Ellenleong/2025-26-RCJ-Soccer-IR-PCMS/README.md

# 2025-26-RCJ-Soccer-IR-PCMS
Record some soccer robot-related content from this year.
