Ellenleong/2025-26-RCJ-Soccer-IR-PCMS/Hardware/PCB/PCB circuit schematic/ir_pcb.png

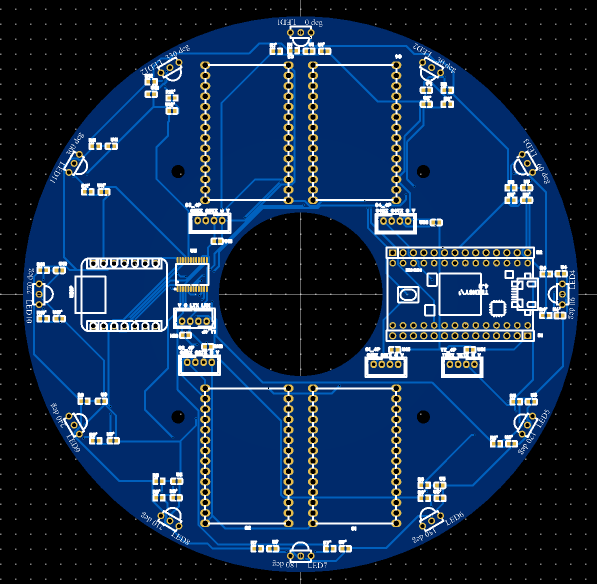
Hardware/PCB/PCB circuit schematic/ir_pcb.png
