Ellenleong/2025-26-RCJ-Soccer-IR-PCMS/Hardware/PCB/PCB circuit schematic/main_pcb.png

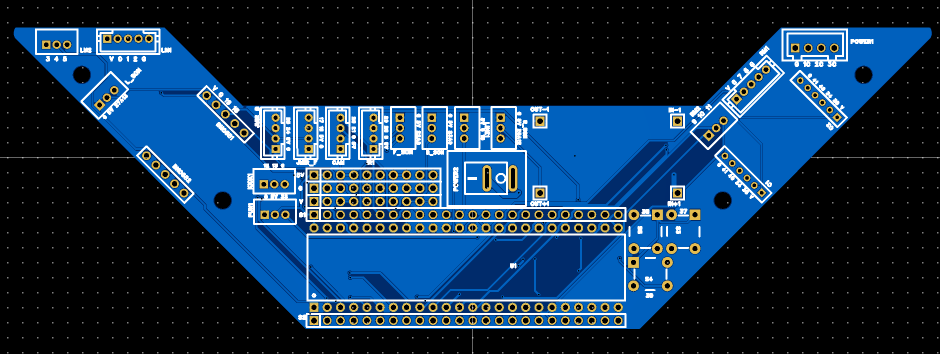
Hardware/PCB/PCB circuit schematic/main_pcb.png
