Ellenleong/2025-26-RCJ-Soccer-IR-PCMS/Hardware/Airframe design CAD file/dribbler/dribbler/Dribbler_assembled.step

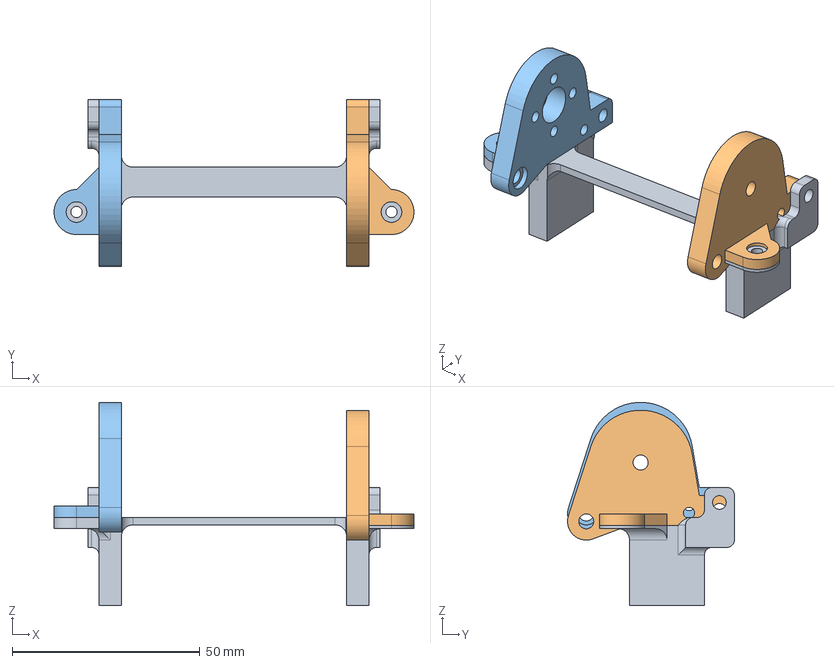
[picture p47: CAD file, 2026-06-27]
Hardware/Airframe design CAD file/dribbler/dribbler/Dribbler_assembled.step
96.0 x 44.5 x 54.2 mm
Dribbler_V3_P1
Dribbler_V3_P2
Dribbler_V3_P3
