Ellenleong/2025-26-RCJ-Soccer-IR-PCMS/Hardware/Airframe design CAD file/batteryholder/BatteryHolder.step

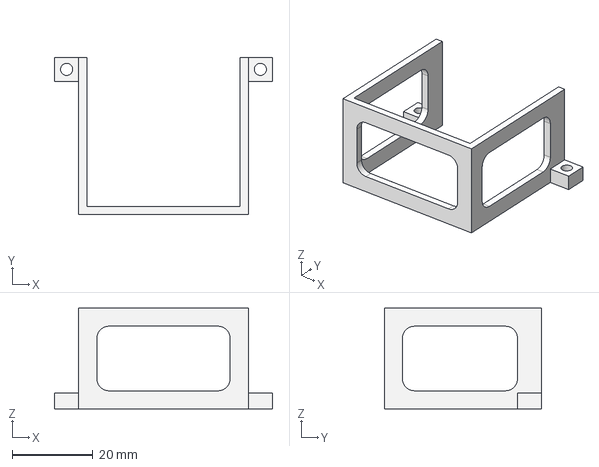
[picture p48: CAD file, 2026-06-27]
Hardware/Airframe design CAD file/batteryholder/BatteryHolder.step
54.0 x 39.0 x 25.0 mm
