Ellenleong/2025-26-RCJ-Soccer-IR-PCMS/Hardware/Airframe design CAD file/dribbler/dribbler/Dribbler_V3_Part1.step

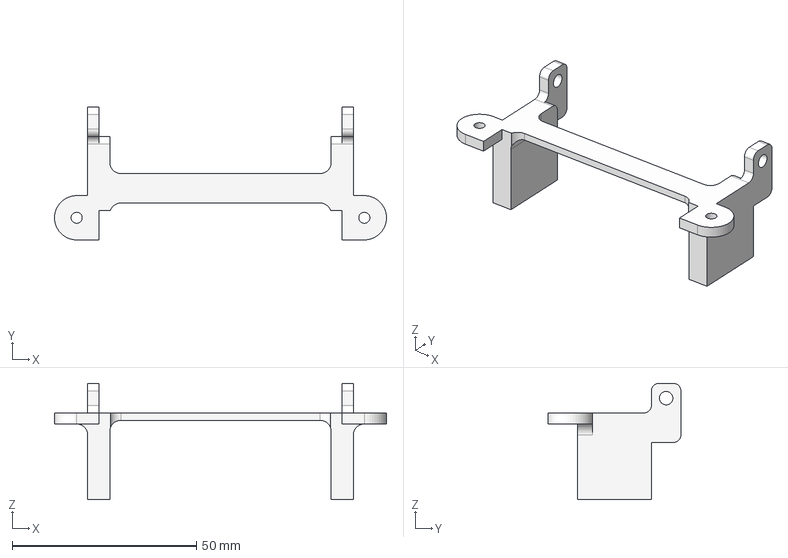
[picture p49: CAD file, 2026-06-27]
Hardware/Airframe design CAD file/dribbler/dribbler/Dribbler_V3_Part1.step
90.0 x 36.0 x 31.5 mm
