Ellenleong/2025-26-RCJ-Soccer-IR-PCMS/Hardware/Airframe design CAD file/dribbler/dribbler_mold/Dribbler_Mold2.step

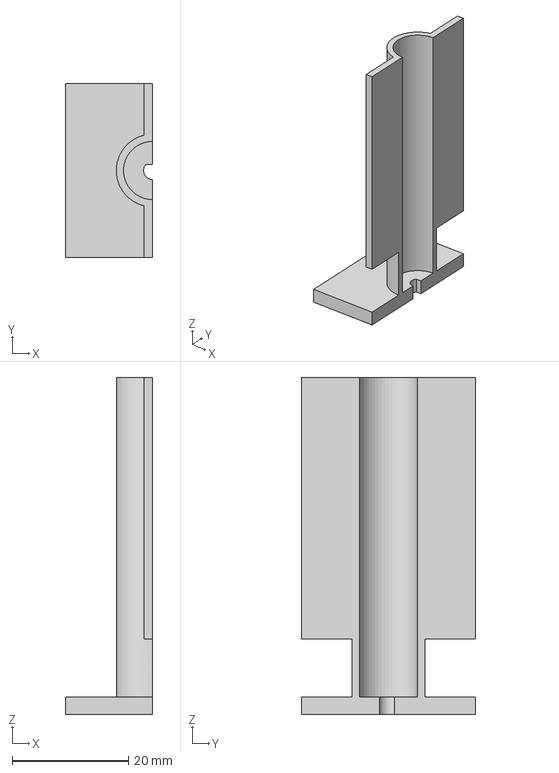
[picture p50: CAD file, 2026-06-27]
Hardware/Airframe design CAD file/dribbler/dribbler_mold/Dribbler_Mold2.step
15.0 x 30.0 x 58.0 mm
