Ellenleong/2025-26-RCJ-Soccer-IR-PCMS/Hardware/Airframe design CAD file/kicker/Kick_Standup_P1.step

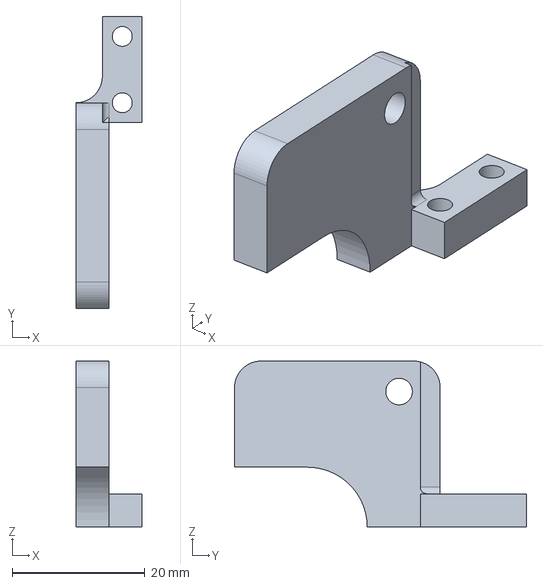
[picture p51: CAD file, 2026-06-27]
Hardware/Airframe design CAD file/kicker/Kick_Standup_P1.step
10.0 x 44.0 x 25.0 mm
