Ellenleong/2025-26-RCJ-Soccer-IR-PCMS/Hardware/Airframe design CAD file/motor/Re16_WheelConnector.step

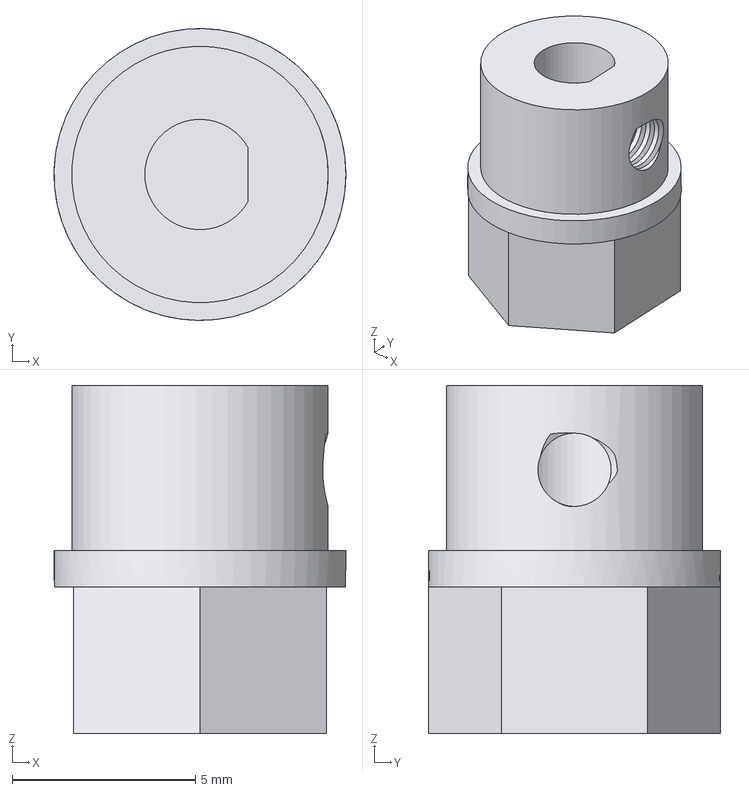
[picture p52: CAD file, 2026-06-27]
Hardware/Airframe design CAD file/motor/Re16_WheelConnector.step
7.97 x 7.97 x 9.50 mm
