Ellenleong/2025-26-RCJ-Soccer-IR-PCMS/Hardware/Airframe design CAD file/omniwheel/Wheel_PartB.step

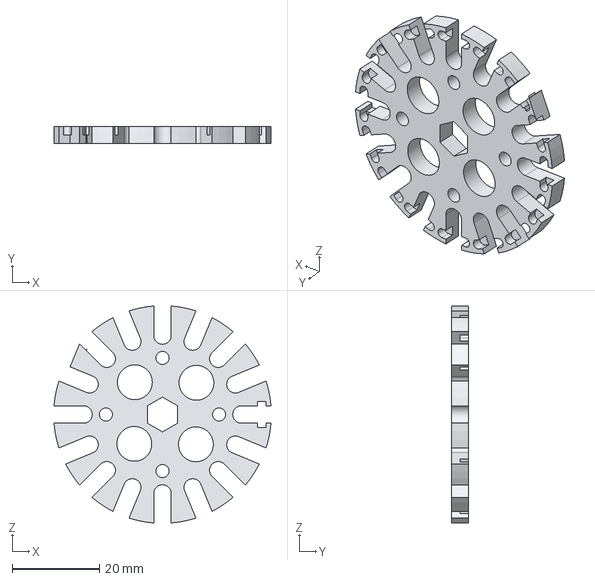
[picture p53: CAD file, 2026-06-27]
Hardware/Airframe design CAD file/omniwheel/Wheel_PartB.step
49.8 x 4.00 x 49.8 mm
