Ellenleong/2025-26-RCJ-Soccer-IR-PCMS/Hardware/Airframe design CAD file/shell/protector to chassis_front1.step

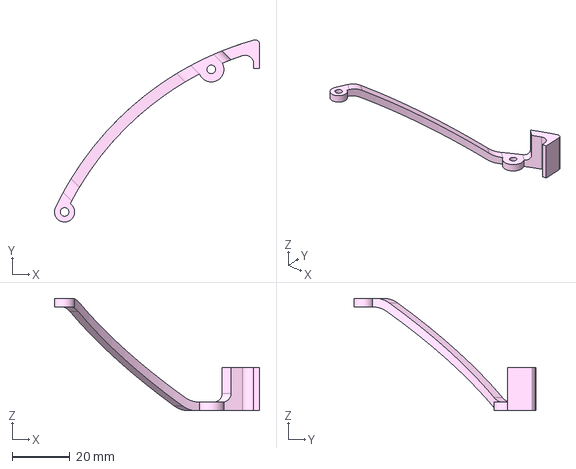
[picture p54: CAD file, 2026-06-27]
Hardware/Airframe design CAD file/shell/protector to chassis_front1.step
71.1 x 63.1 x 39.0 mm
