Ellenleong/2025-26-RCJ-Soccer-IR-PCMS/Hardware/Airframe design CAD file/support_for_sensor/camera&ultrasonic_support.step

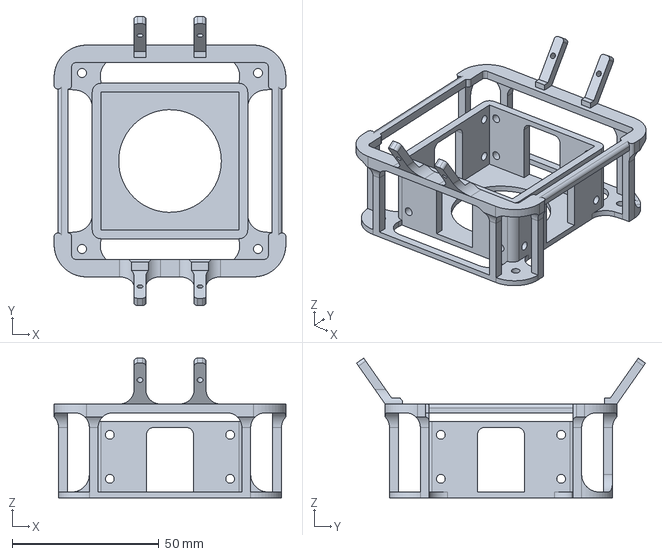
[picture p55: CAD file, 2026-06-27]
Hardware/Airframe design CAD file/support_for_sensor/camera&ultrasonic_support.step
79.0 x 98.5 x 47.6 mm
