Ellenleong/2025-26-RCJ-Soccer-IR-PCMS/Hardware/Airframe design CAD file/dribbler/dribbler/Dribbler_V3_Part2.step

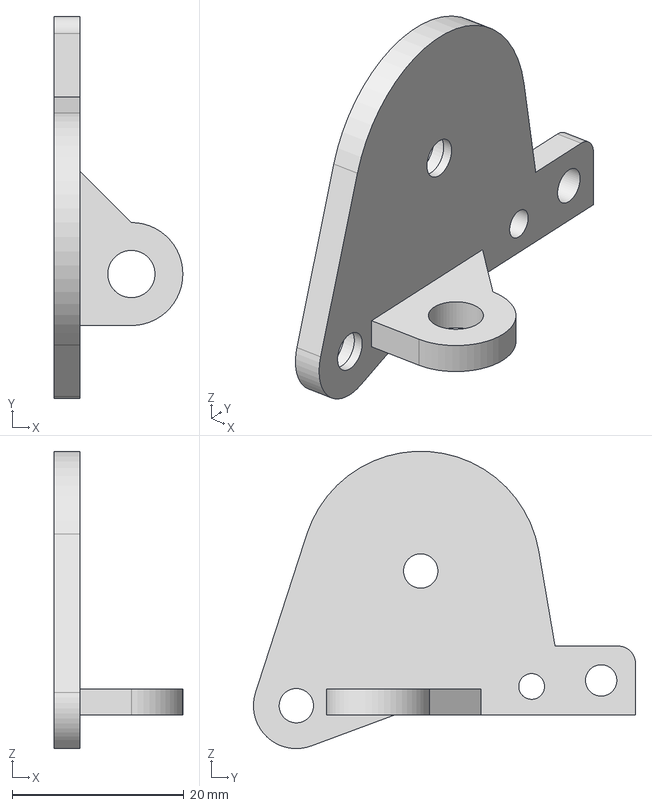
[picture p56: CAD file, 2026-06-27]
Hardware/Airframe design CAD file/dribbler/dribbler/Dribbler_V3_Part2.step
15.0 x 44.5 x 34.6 mm
