Ellenleong/2025-26-RCJ-Soccer-IR-PCMS/Hardware/Airframe design CAD file/dribbler/dribbler_mold/Dribbler_Mold1.step

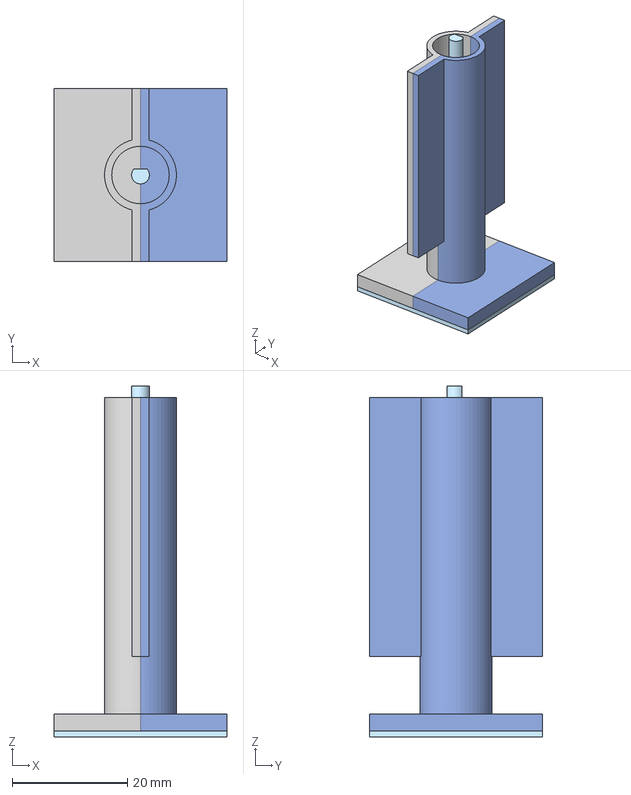
[picture p57: CAD file, 2026-06-27]
Hardware/Airframe design CAD file/dribbler/dribbler_mold/Dribbler_Mold1.step
30.0 x 30.0 x 61.0 mm
