Ellenleong/2025-26-RCJ-Soccer-IR-PCMS/Hardware/Airframe design CAD file/kicker/Kick_Face.step

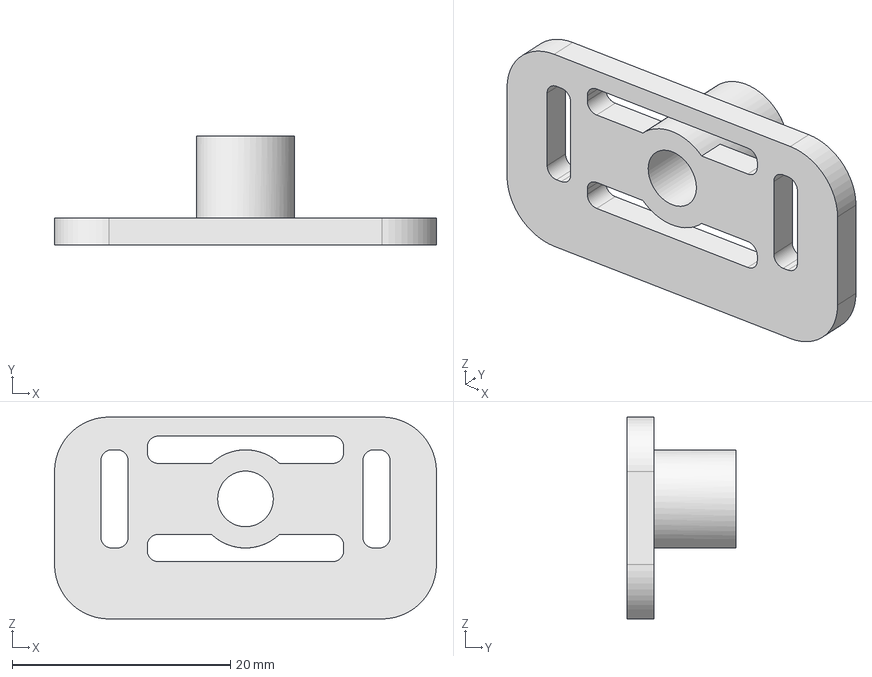
[picture p58: CAD file, 2026-06-27]
Hardware/Airframe design CAD file/kicker/Kick_Face.step
35.0 x 10.0 x 18.5 mm
