Ellenleong/2025-26-RCJ-Soccer-IR-PCMS/Hardware/Airframe design CAD file/motor/Re16_Stand.step

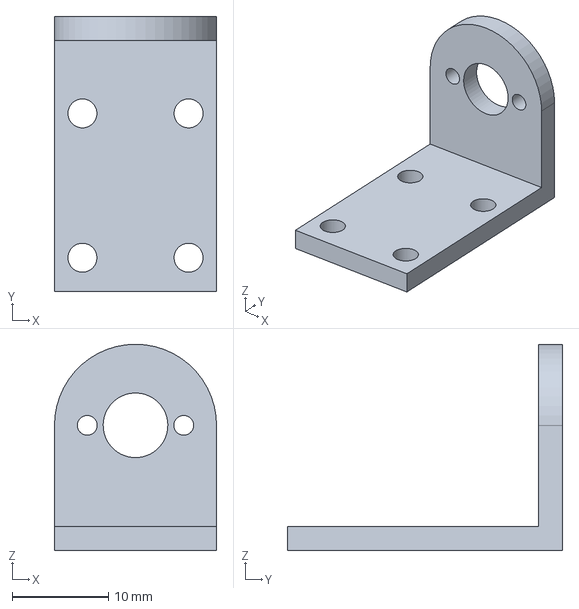
[picture p59: CAD file, 2026-06-27]
Hardware/Airframe design CAD file/motor/Re16_Stand.step
16.8 x 28.5 x 21.4 mm
