Ellenleong/2025-26-RCJ-Soccer-IR-PCMS/Hardware/Airframe design CAD file/omniwheel/Wheel_PartA.step

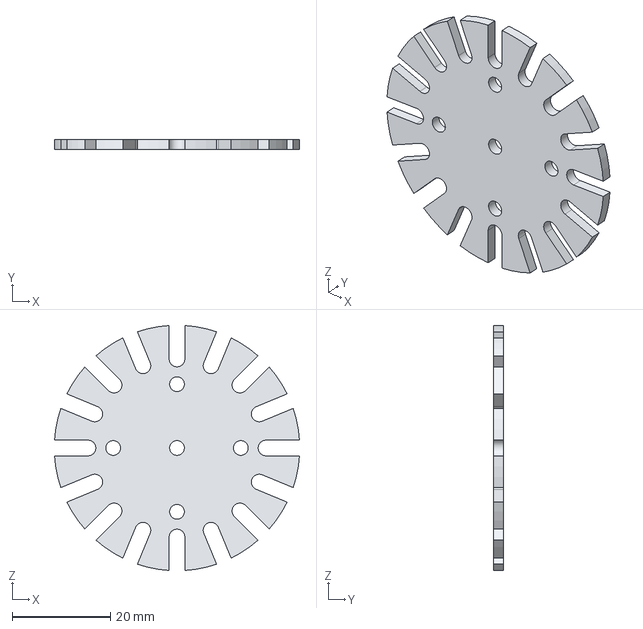
[picture p60: CAD file, 2026-06-27]
Hardware/Airframe design CAD file/omniwheel/Wheel_PartA.step
49.9 x 2.00 x 49.9 mm
