Ellenleong/2025-26-RCJ-Soccer-IR-PCMS/Hardware/Airframe design CAD file/shell/protector to chassis.step

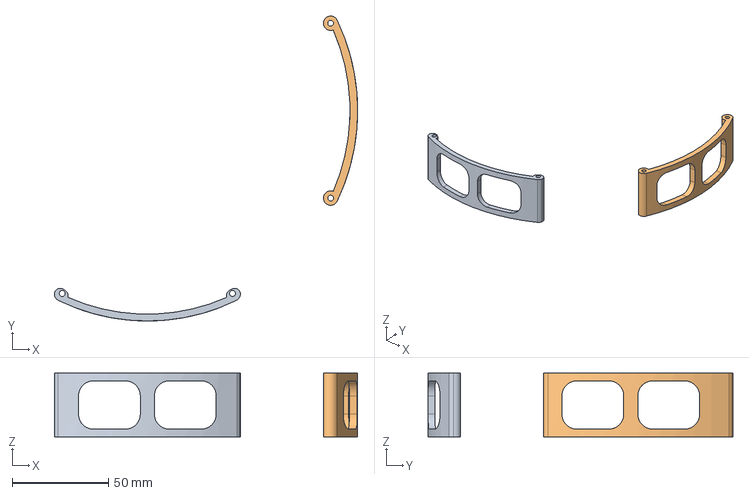
[picture p61: CAD file, 2026-06-27]
Hardware/Airframe design CAD file/shell/protector to chassis.step
157.2 x 158.1 x 33.0 mm
