Ellenleong/2025-26-RCJ-Soccer-IR-PCMS/Hardware/Airframe design CAD file/dribbler/dribbler/Dribbler_V3_Part3.step

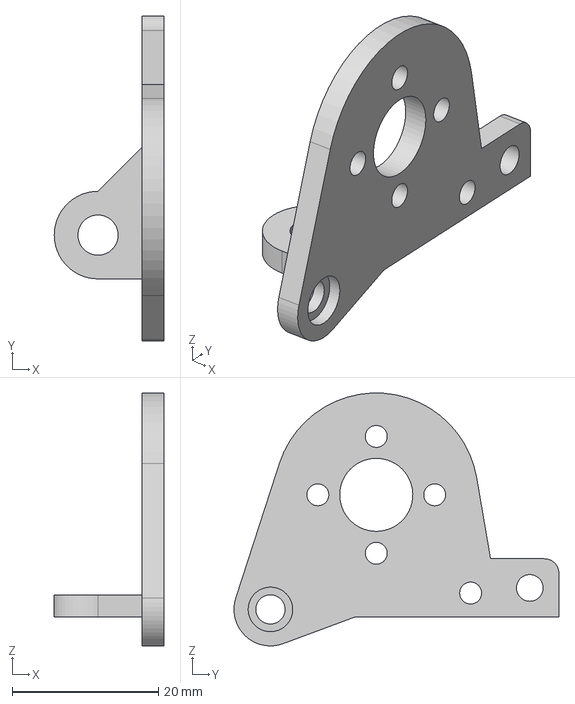
[picture p62: CAD file, 2026-06-27]
Hardware/Airframe design CAD file/dribbler/dribbler/Dribbler_V3_Part3.step
15.0 x 44.5 x 34.6 mm
