Ellenleong/2025-26-RCJ-Soccer-IR-PCMS/Hardware/Airframe design CAD file/shell/wheelprotector.step

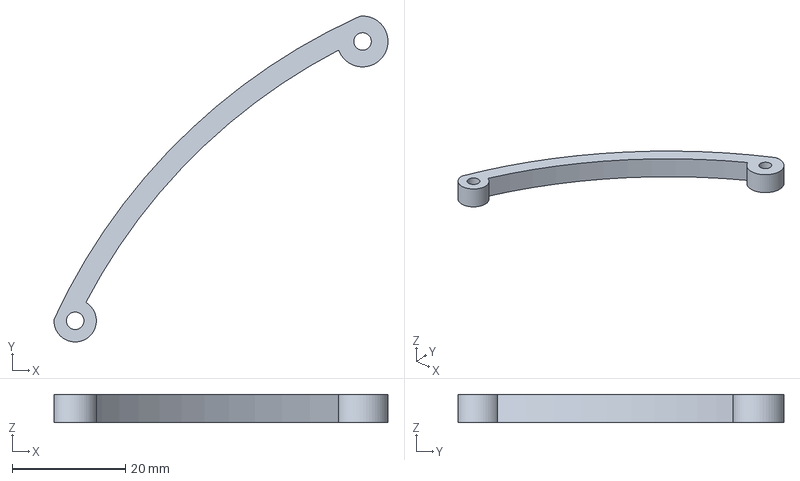
[picture p63: CAD file, 2026-06-27]
Hardware/Airframe design CAD file/shell/wheelprotector.step
59.1 x 57.7 x 5.00 mm
