Ellenleong/2025-26-RCJ-Soccer-IR-PCMS/(list of files, cad)

Other CAD files:
Hardware/Airframe design CAD file/kicker/Kick_Standup_P2.step
Hardware/Airframe design CAD file/shell/protector to chassis_front2.step
