Ellenleong/2025-26-RCJ-Soccer-IR-PCMS/Hardware/PCB/PCB 3D View/IRcircuit.pdf

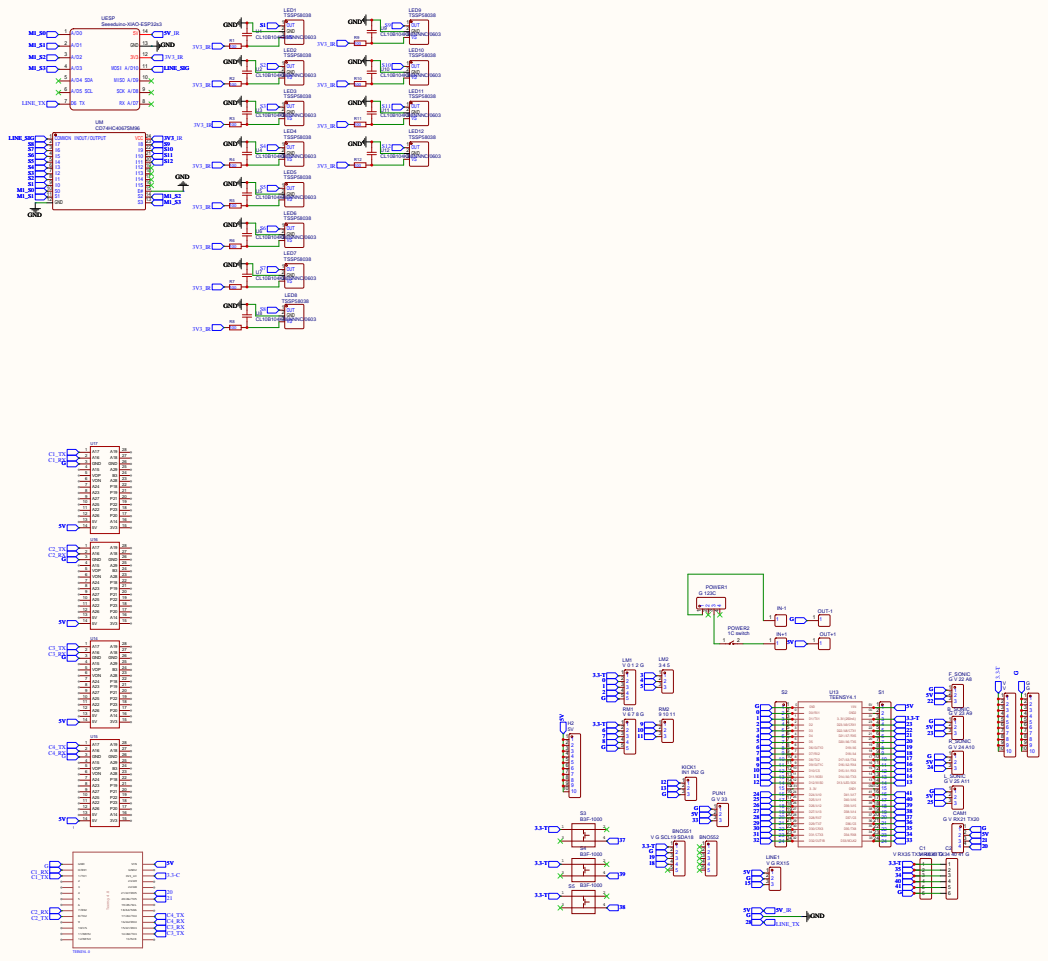
[picture p64: page 1]

原理图 | PCB_Main_IR_0504_V1 | 创建日期 | 2026-05-04

更新日期 | 2026-05-05

板子 | PCB_Main_IR_0504 | 图页 | P1
绘制 | | PCB_IR_03_29_V2
审阅

V1.0 | A4 | 嘉立创EDA
