Ellenleong/2025-26-RCJ-Soccer-IR-PCMS/Hardware/PCB/PCB 3D View/Kicker_circuit.pdf

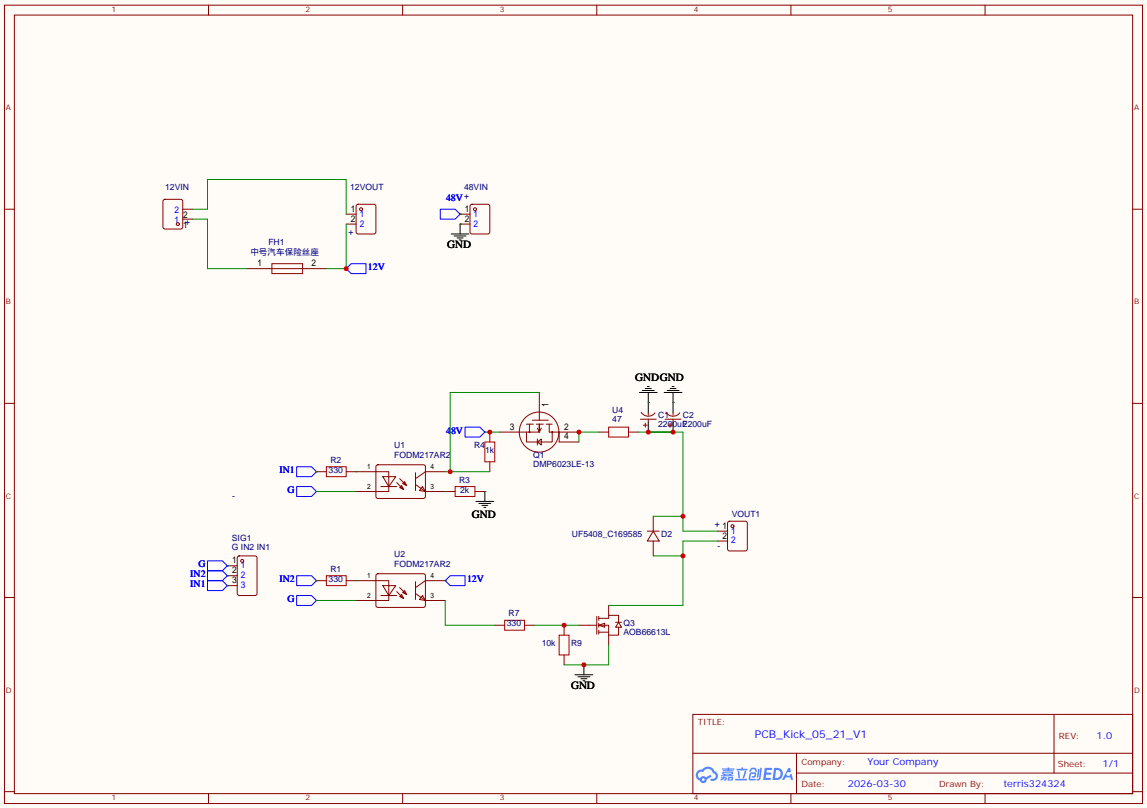
[picture p65: page 1]
