Ellenleong/2025-26-RCJ-Soccer-IR-PCMS/Hardware/PCB/PCB 3D View/Line_circuit.pdf

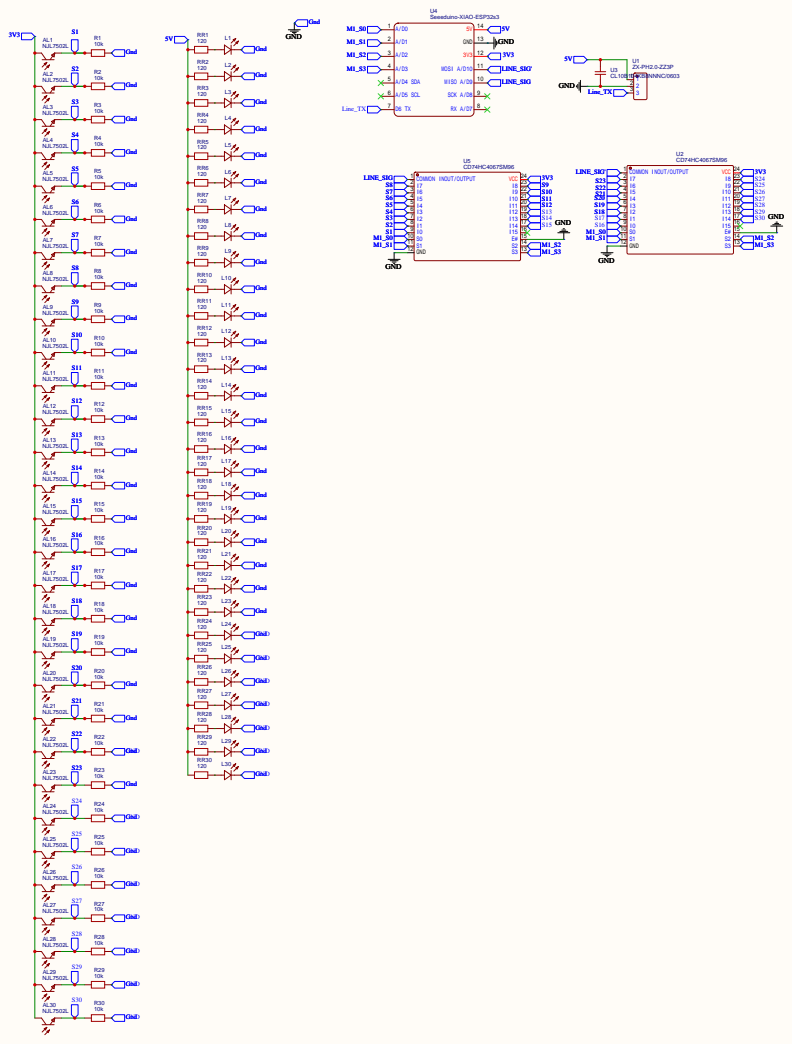
[picture p66: page 1]
