Ellenleong/2025-26-RCJ-Soccer-IR-PCMS/Hardware/PCB/PCB 3D View/mainPCB_circuit.pdf

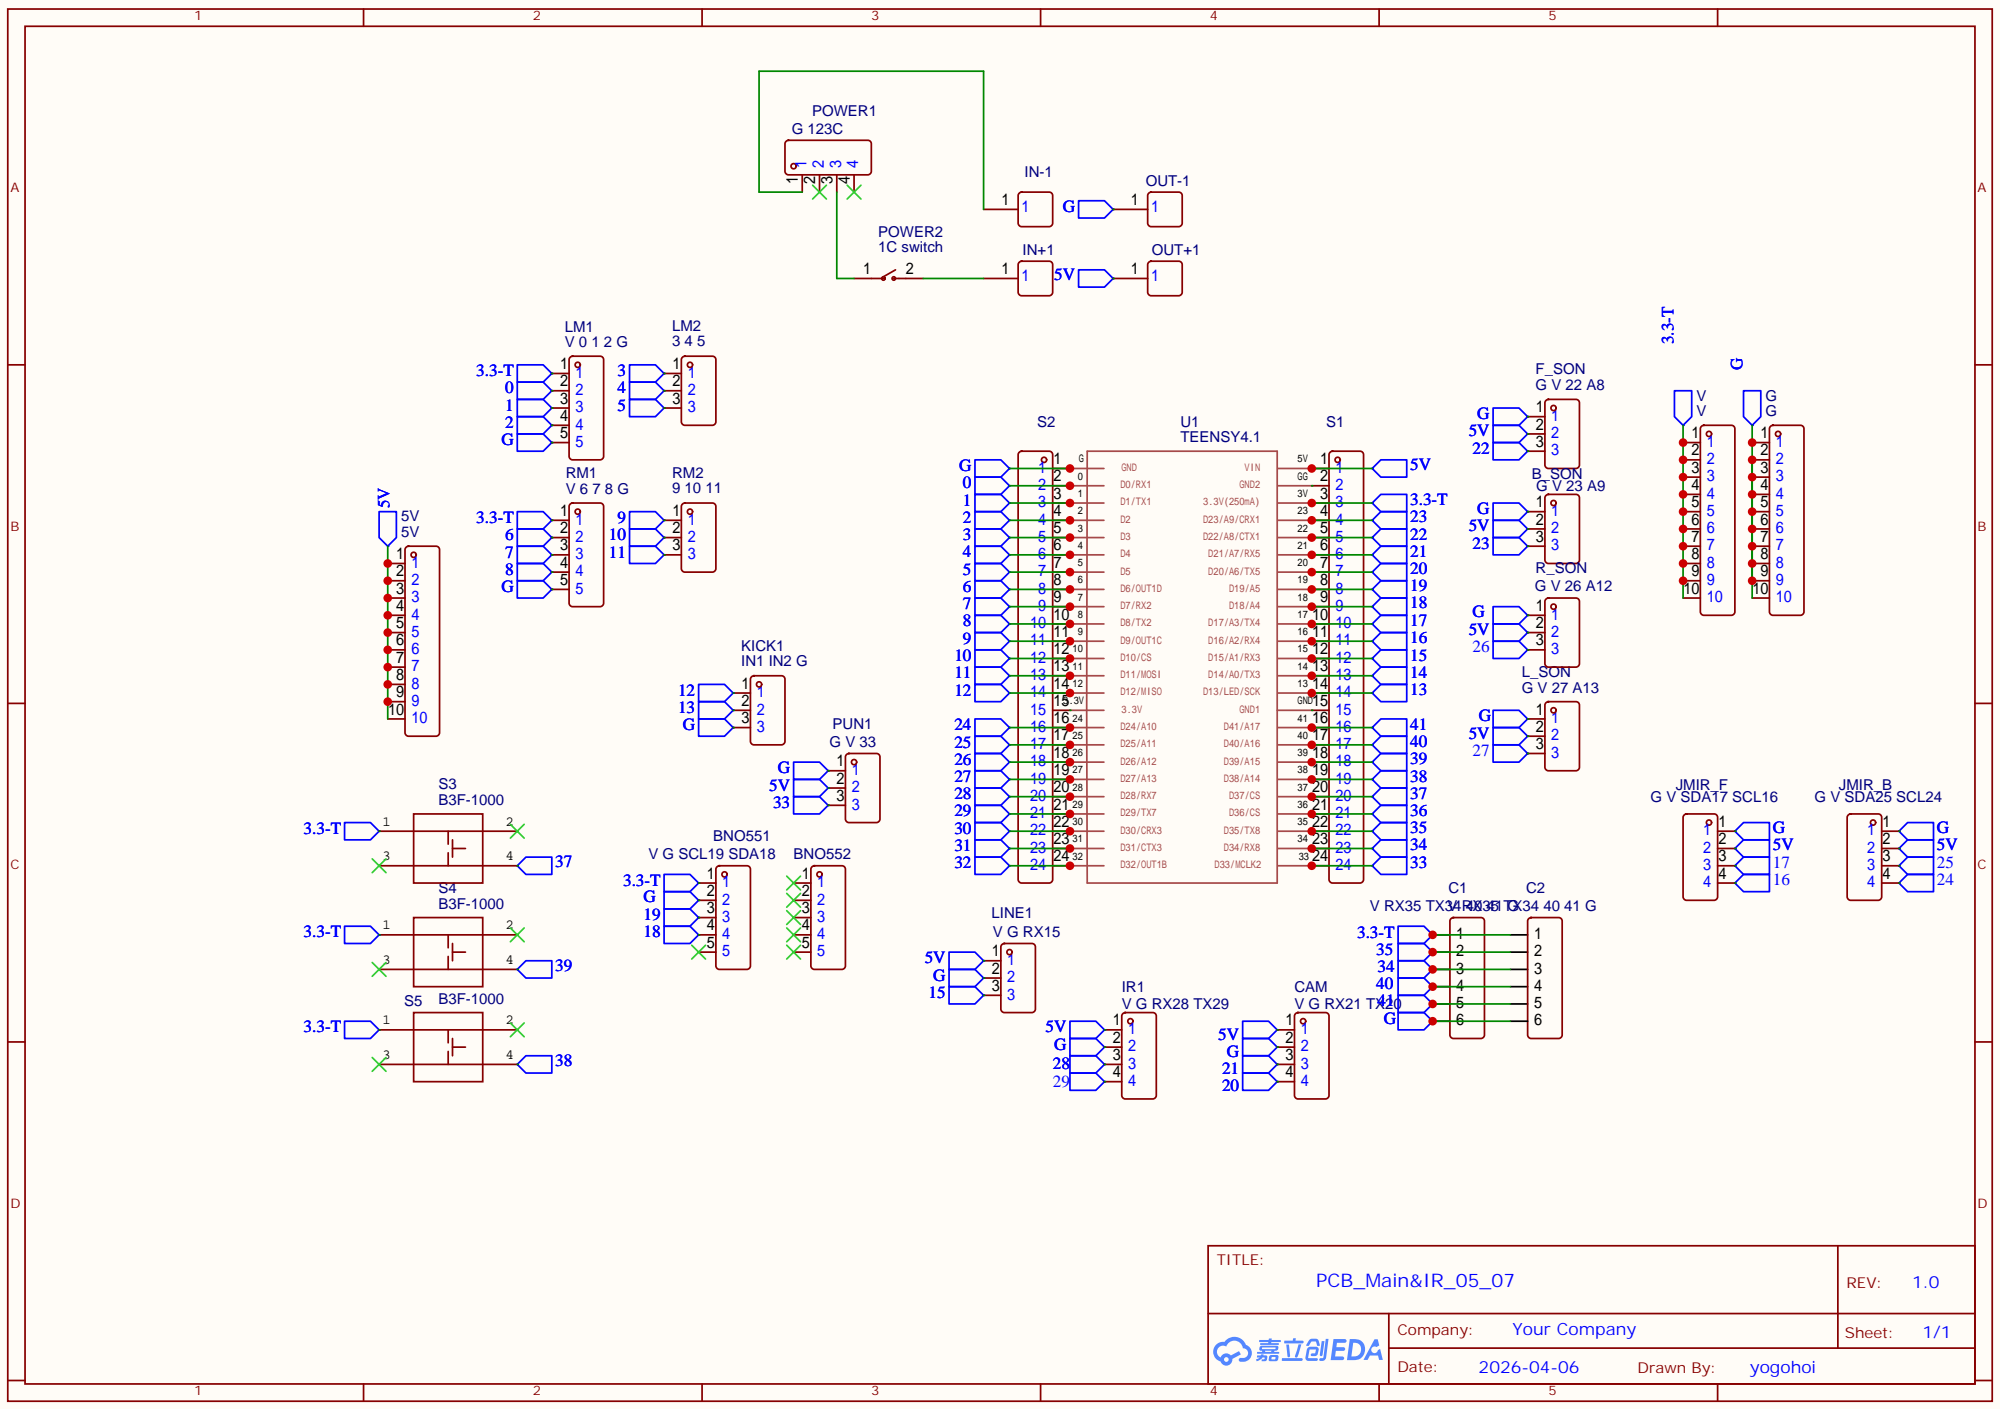
[picture p67: page 1]
