Ellenleong/2025-26-RCJ-Soccer-IR-PCMS/(commit log)

2026-06-27 Establish project folder structure and upload initial hardware files
    [BatteryHolder.step, Dribbler_Mold1.step, Dribbler_Mold2.step, Dribbler_V3_Part1.step, Dribbler_V3_Part2.step, Dribbler_V3_Part3.step, Dribbler_assembled.step, Kick_Face.step]
2026-06-27 flow chart
